recepsaglam/umay/hardware/umay/docs/PCBTopView.png

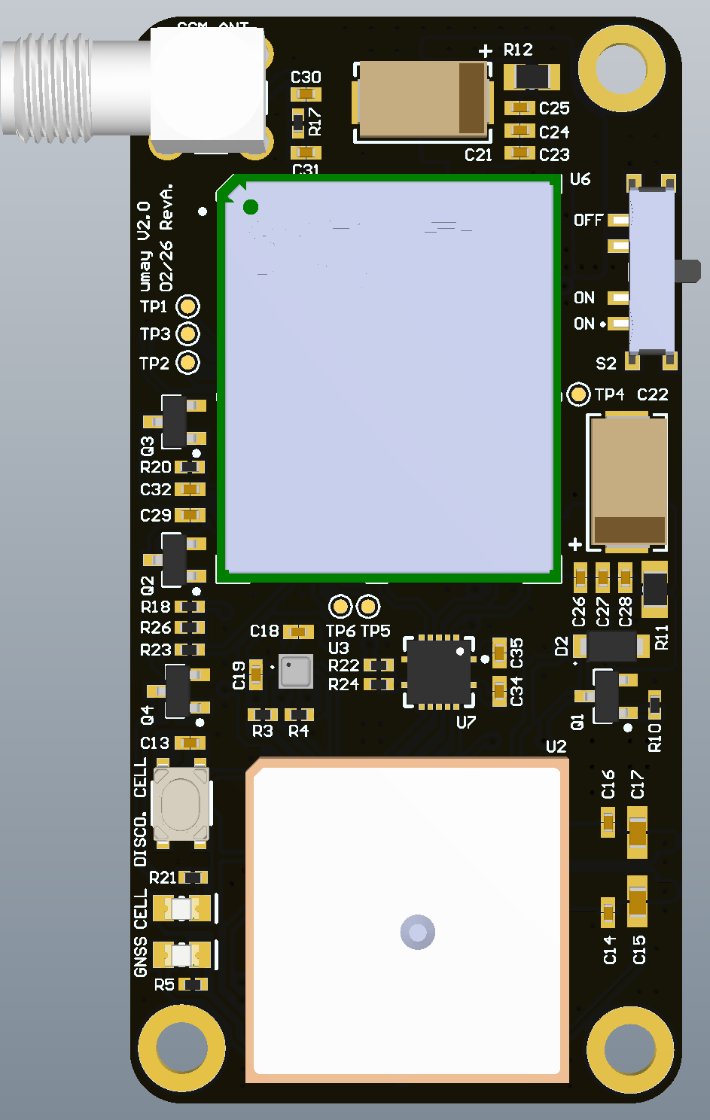
hardware/umay/docs/PCBTopView.png
