recepsaglam/umay/docs/GNSS_and_GSM_Module_Selection.docx

Module Selection Justification

Within the scope of the UMAY project, the Quectel EG915N has been selected as the primary communication module. This decision was made after a detailed evaluation of technical, logistical, and operational factors.

1. Availability and Supply Chain Reliability

The EG915N module is widely available in the Turkish market, offered by multiple authorized distributors. This ensures short lead times and reduces the risks associated with supply disruptions.
In contrast, the SIMCom A7672E module is available through a limited number of vendors, introducing potential sourcing and continuity risks during production.

2. Cost and Integration Advantages

The EG915N provides a cost-effective and integration-friendly solution among LTE Cat 1 modules. Its design requires fewer external components, which simplifies PCB layout and lowers overall system cost.
Additionally, the module’s low power consumption makes it well-suited for battery-powered applications, aligning with the UMAY project’s objective of maximizing endurance and operational efficiency.

3. Technical Capability and Future-Proof Architecture

Supporting LTE Cat 1 connectivity with 2G fallback, the EG915N ensures reliable data transmission even in regions with limited LTE coverage.
Modules based solely on 2G technology were excluded, as 2G networks are gradually being phased out in many regions and cannot meet the project’s performance and latency requirements.
Therefore, adopting an LTE Cat 1 module ensures long-term compatibility, improved throughput, and reduced latency, making the system more robust and sustainable.

4. Manufacturing Considerations

The EG915N utilizes an LCC/LGA package, which may present soldering challenges during manufacturing. However, with appropriate PCB footprint design and optimized reflow soldering parameters, reliable assembly quality can be achieved.

5. GNSS Performance Optimization

Although the EG915N includes a built-in GNSS receiver, its performance heavily depends on antenna characteristics.
In particular, chip antennas typically operate near the minimum Carrier-to-Noise Density (C/N₀) threshold required for stable navigation message decoding.
This means that, to achieve reliable GNSS performance using the EG915N’s internal receiver, a ceramic patch antenna would be required.
However, integrating such an antenna would eliminate the size advantage of the chip antenna approach and add design complexity.

For this reason, the decision was made to include a dedicated u-blox L86 GNSS module.
While the L86 introduces additional cost and higher power consumption, it provides significantly improved positioning reliability, multi-constellation support (GPS, GLONASS, GALILEO), and faster Time to First Fix (TTFF) performance.
This ensures accurate and consistent position tracking even under challenging signal conditions.

Summary

The selection of the Quectel EG915N was primarily driven by:

- Cost efficiency and strong local market availability,
- Simplified integration and low power operation,
- LTE Cat 1 capability with reliable 2G fallback,
- Long-term network sustainability.

Furthermore, the integration of the L86 GNSS module—instead of relying on the EG915N’s internal GNSS—was based on performance considerations.
Although it increases cost and power consumption, it provides a more stable and precise positioning subsystem, ensuring that the UMAY project achieves high reliability in real-world operational conditions.
