recepsaglam/umay/hardware/umay/docs/PCBBottomView.png

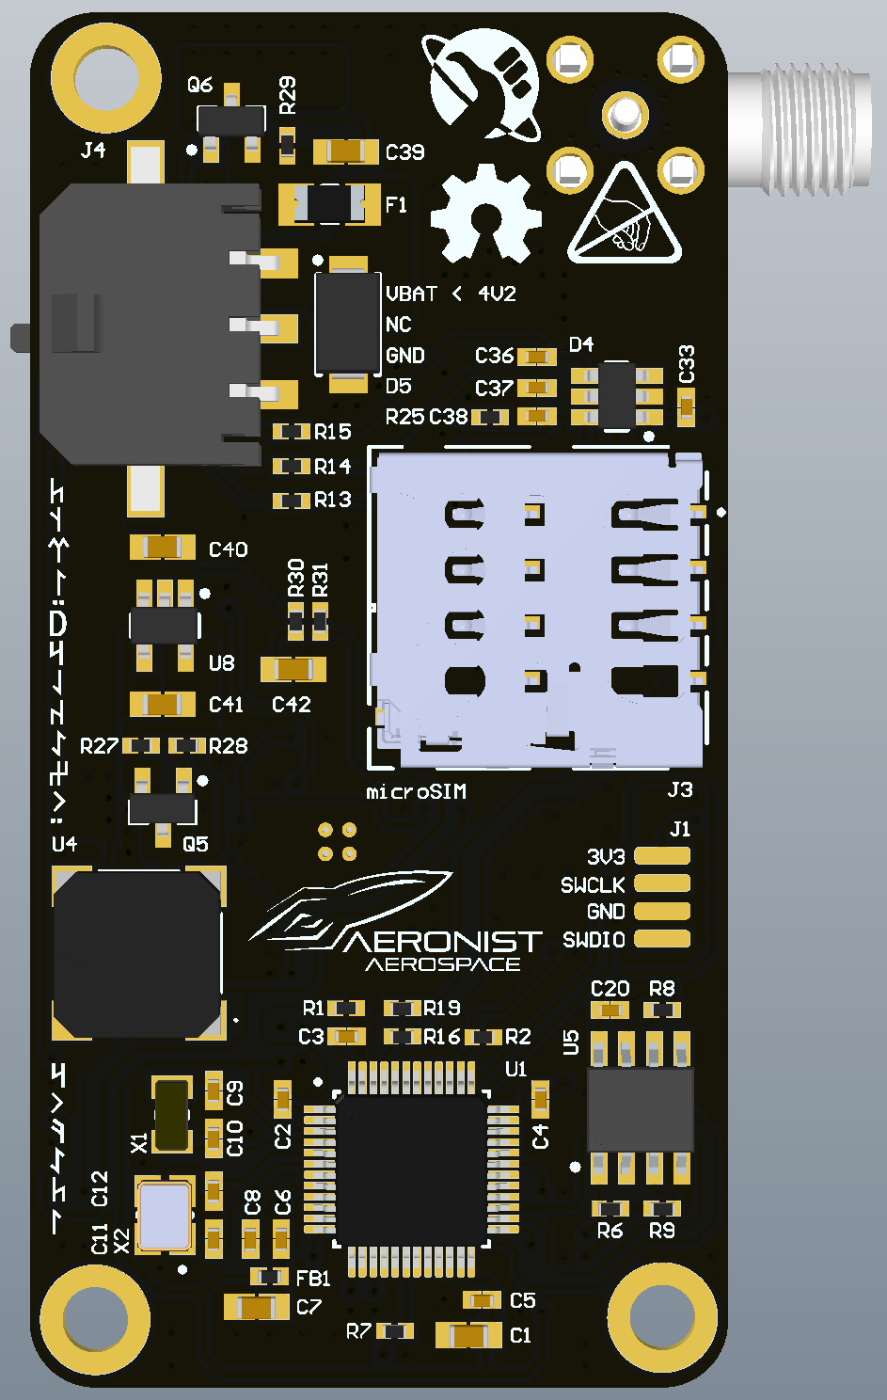
hardware/umay/docs/PCBBottomView.png
