recepsaglam/umay/hardware/umay/fabrication/umayBOM.xlsx

 | Bill of Materials
 | Source Data From: | umay.PrjPcb
 | Project File Name: | umay.PrjPcb
 | Report Date: | 4.03.2026
 | Author:
Designator | Comment | Footprint | Description | Quantity | Supplier Part Number 1 | Supplier 1 | Supplier Unit Price 1 | Link
C1, C17 | 4u7 | CAP 0603 | Capacitor SMD 0603 | 2
C2, C3, C4, C5, C6, C8, C13, C14, C16, C18, C19, C20, C25, C28, C33, C34, C35 | 100n | CAP 0402 | Capacitor SMD 0402 | 17
C7, C39, C40, C41, C42 | 1u | CAP 0603 | Capacitor SMD 0603 | 5
C9, C10 | 6p | CAP 0402 | Capacitor SMD 0402 | 2
C11, C12 | 18p | CAP 0402 | Capacitor SMD 0402 | 2
C15 | 10u | CAP 0603 | Capacitor SMD 0603 | 1
C21, C22 | 100u | CAP TANT D Case | Capacitor Tantalum SMD D Case | 2
C23, C26 | 10p | CAP 0402 | Capacitor SMD 0402 | 2
C24, C27, C36, C37, C38 | 33p | CAP 0402 | Capacitor SMD 0402 | 5
C29, C32 | 10n | CAP 0402 | Capacitor SMD 0402 | 2
C30, C31 | NM | CAP 0402 | Capacitor SMD 0402 | 2
D1, D3 | LED 0805 | LED 0805 | LED 0805 SMD | 2
D2 | SS2060FL | SOD-123FL | Rectifier Diode, Schottky, 1 Phase, 1 Element, 2A, 60V V(RRM), Silicon | 1
D4 | SRV05-4 | SOT-23-6 | SRV Series 17.5 V 3 pF SMT RailClamp® Low Capacitance TVS Diode Array SOT-23-6 | 1
D5 | SMAJ5.0A-E3/61 | SMA | SMAJ Series SMT Bi/Uni-Directional Transient Voltage Suppressor - SMA | 1
F1 | KLM3S350RY | PTC 1206 | PTC Resettable Fuse | 1
FB1 | 600 Ω @ 100 MHz | FB 0402 | Ferrite Bead SMD 0402 | 1
J1 | CONN 1x4 Pad 1.27mm | CONN 1x4 PAD 1.27mm | 1×4 pin header connector, 1.27 mm pitch. | 1
J2 | L-KLS1-SMA-KWE-7X7-15.1 | CONN SMA THT R/A | RF SMA Connector, 1 Contact(s), Board Mount, R/A | 1
J3 | 115I-AEAA | 115I-AEAA | 115I-AEAA Connector Micro SIM Card Push-Pull 6P SMD Card Edge Connectors | 1
J4 | L-KLS1-XM1-3.00-1X03-RT | CONN 1X3 MICRO-FIT 3.00MM | 1×2 Micro Fit type connector, 3.0 mm pitch, surface-mount. | 1
Q1, Q2, Q3, Q4 | PJA3404A | SOT23-3 | SOT-23-3 package, N-Channel MOSFET | 4
Q5, Q6 | SI2365EDS | SOT23-3 | SOT-23-3 package, P-Channel MOSFET | 2
R1, R2, R22 | 10k | RES 0402 | Resistor SMD 0402 | 3
R3, R4, R6, R7, R8, R9, R16, R19, R23 | 4k7 | RES 0402 | Resistor SMD 0402 | 9
R5, R21 | 1k | RES 0402 | Resistor SMD 0402 | 2
R10, R18, R20, R26 | 47k | RES 0402 | Resistor SMD 0402 | 4
R11, R12 | 0R | RES 0805 | Resistor SMD 0805 | 2
R13, R14, R15, R17 | 0R | RES 0402 | Resistor SMD 0402 | 4
R24 | 120k | RES 0402 | Resistor SMD 0402 | 1
R25 | 15k | RES 0402 | Resistor SMD 0402 | 1
R27, R31 | 100k | RES 0402 | Resistor SMD 0402 | 2
R28 | 330R | RES 0402 | Resistor SMD 0402 | 1
R29, R30 | 33k | RES 0402 | Resistor SMD 0402 | 2
S1 | SW Tact 4.6x3.2mm | SW TACT 4.6X3.2MM | 4.6×3.2 mm tactile push-button switch, SPST, momentary, SMD. | 1
S2 | SSSS812201 | SSSS812201 | Slide Switch / Switch Slide SP3T Side Slide 0.3A 5VDC 10000Cycles Gull Wing SMD T/R | 1
TP1, TP2, TP3, TP4, TP5, TP6 | Test Point | Test Point | Test Point, PCB Pad Only, Ø1.2mm | 6
U1 | STM32L071CBT6 | LQFP48 | MCU 32-Bit Ultra Low Power STM32L ARM Cortex M0+ RISC 128kB Flash 48-Pin LQFP Tray | 1
U2 | L86-M33 | L86-M33 | GNSS Module, Galileo, GLONASS, GPS, QZSS, 1.57542GHz, 1.60171GHz, -167 dBm, 35 s, 3V to 4.3V | 1
U3 | BMP390 | BMP390 | Pressure sensor, 300-1250hPa, 2.0*2.0*0.75mm, I2C/SPI | 1
U4 | MTS7525A04LM | MTS7525A04LM | 7.5 x 7.5 mm magnetic passive buzzer, SMT, 3.6 V (2.5–4.5 V), 2.7 kHz, 85 dB. | 1
U5 | W25Q64JVSSIQ | SOP-8 | NOR Flash Serial (SPI, Dual SPI, Quad SPI) 3V/3.3V 64M-bit 8M x 8 6ns 8-Pin SOIC T/R/Tray/Tube | 1
U6 | EG915N-EA | EG915N | Cellular, Navigation BeiDou, EDGE, Galileo, GLONASS, GNSS, GPRS, GPS, GSM, HSPA+, LTE, UMTS, WCDMA Transceiver Module 915MHz Antenna Not Included Surface Mount | 1
U7 | TXS0104ERGYR | VQFN-14 | Four-bit bidirectional voltage-level shifter for open-drain and push-pull applications 14-VQFN -40 to 85 | 1
U8 | TLV73333PDBVR | SOT23-5 | 300-mA, capacitor-free, low-IQ, low-dropout voltage regulator with enable 5-SOT-23 -40 to 125 | 1
X1 | RT3215-32.768-6 | RT3215-32.768-X | Parallel - Fundamental Quartz Crystal, 0.032768MHz Nom | 1
X2 | RH100-8.000-12.5 | RH100 | RH100 Series Crystal, X Mhz, X pF, Smd, 3.2Mm X 2.5Mm Raltron | 1
 |  |  |  | 106 |  |  | ₺0.00
