recepsaglam/umay/(list of files, cad)

Other CAD files:
mechanical/LiPo_1S.CATPart
mechanical/SMA_Antenna.CATPart
mechanical/case.CATProduct
mechanical/case_bottom.CATPart
mechanical/case_top.CATPart
mechanical/umay.CATPart
