recepsaglam/umay/hardware/umay/docs/umaySCH.pdf

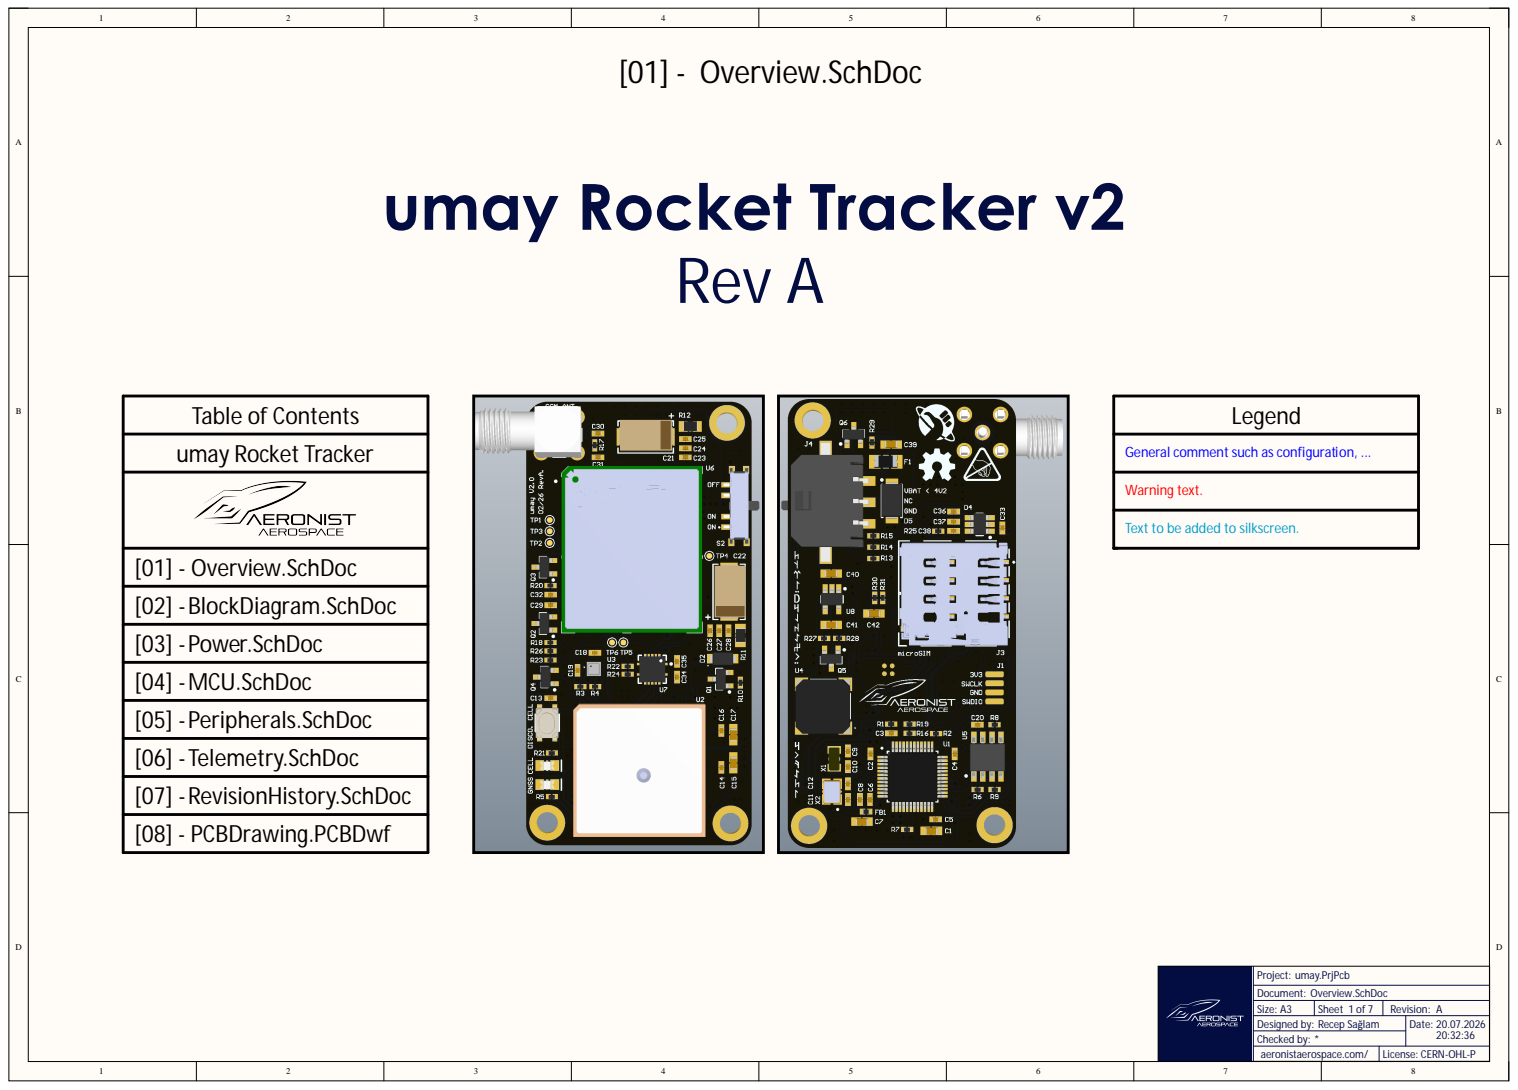
[picture p3: page 1]

General comment such as configuration, ...

Text to be added to silkscreen.

Size: A3 | Sheet of 1 7 | Revision: A
Designed by: Recep Sağlam | Date: 20.07.2026 20:32:36

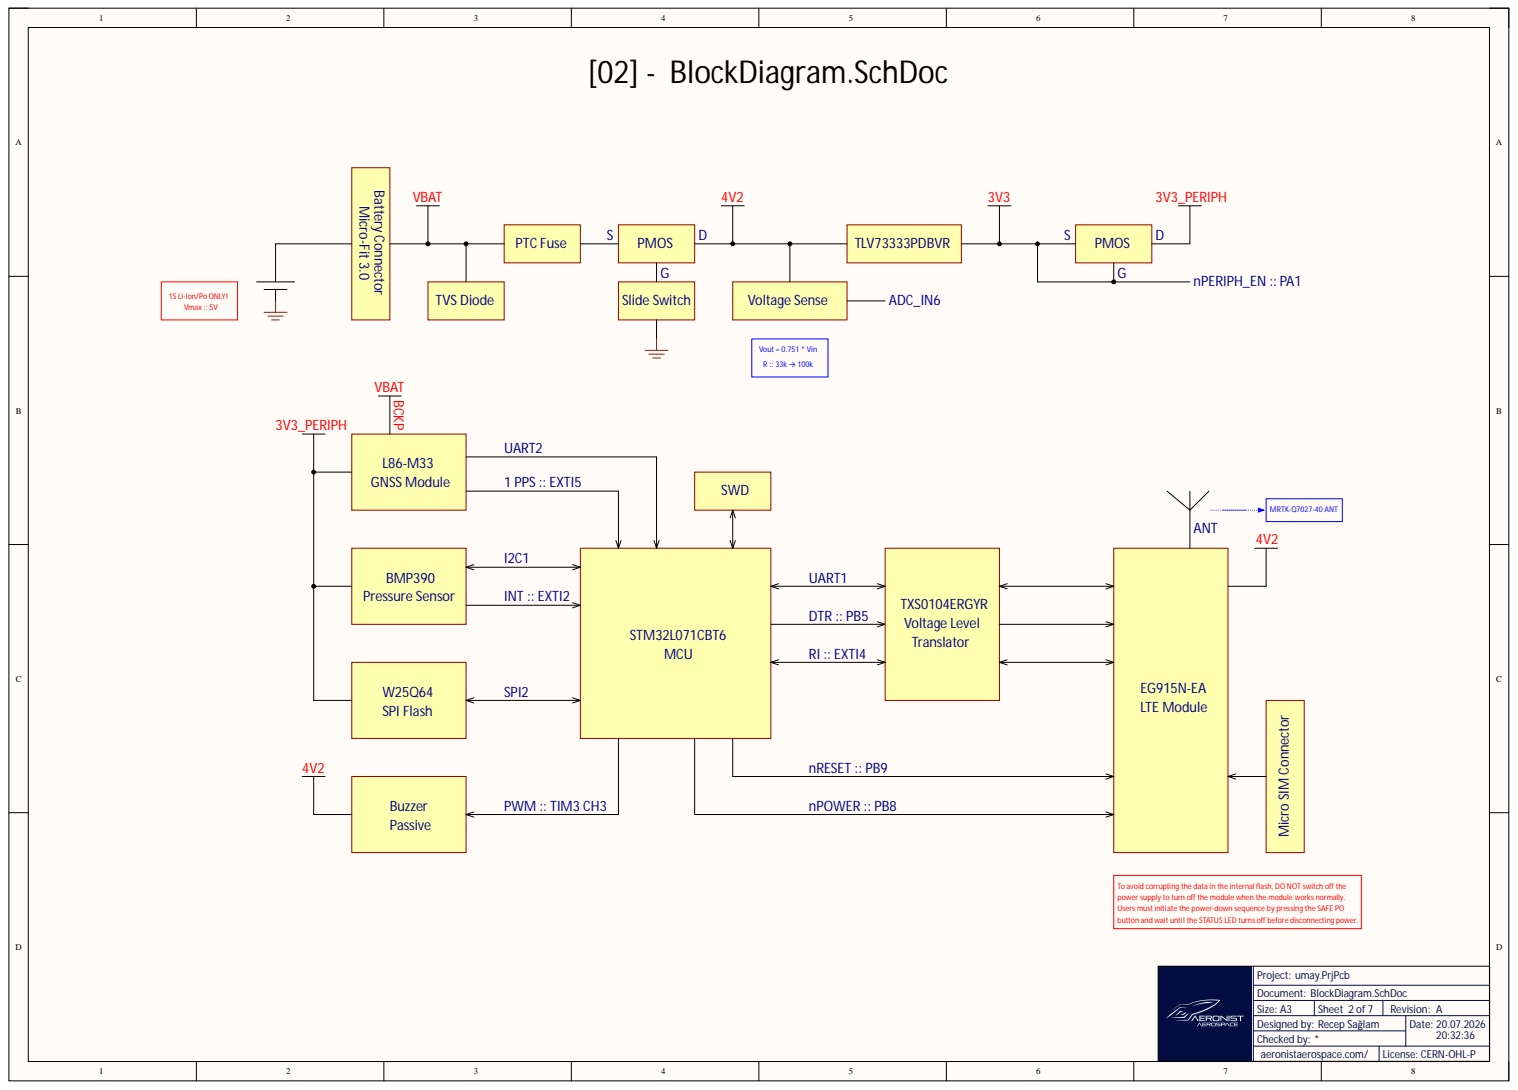
[picture p4: page 2]

1S Li-Ion/Po ONLY!
Vmax :: 5V

To avoid corrupting the data in the internal flash, DO NOT switch off the
power supply to turn off the module when the module works normally.
Users must initiate the power-down sequence by pressing the SAFE PO
button and wait until the STATUS LED turns off before disconnecting power.

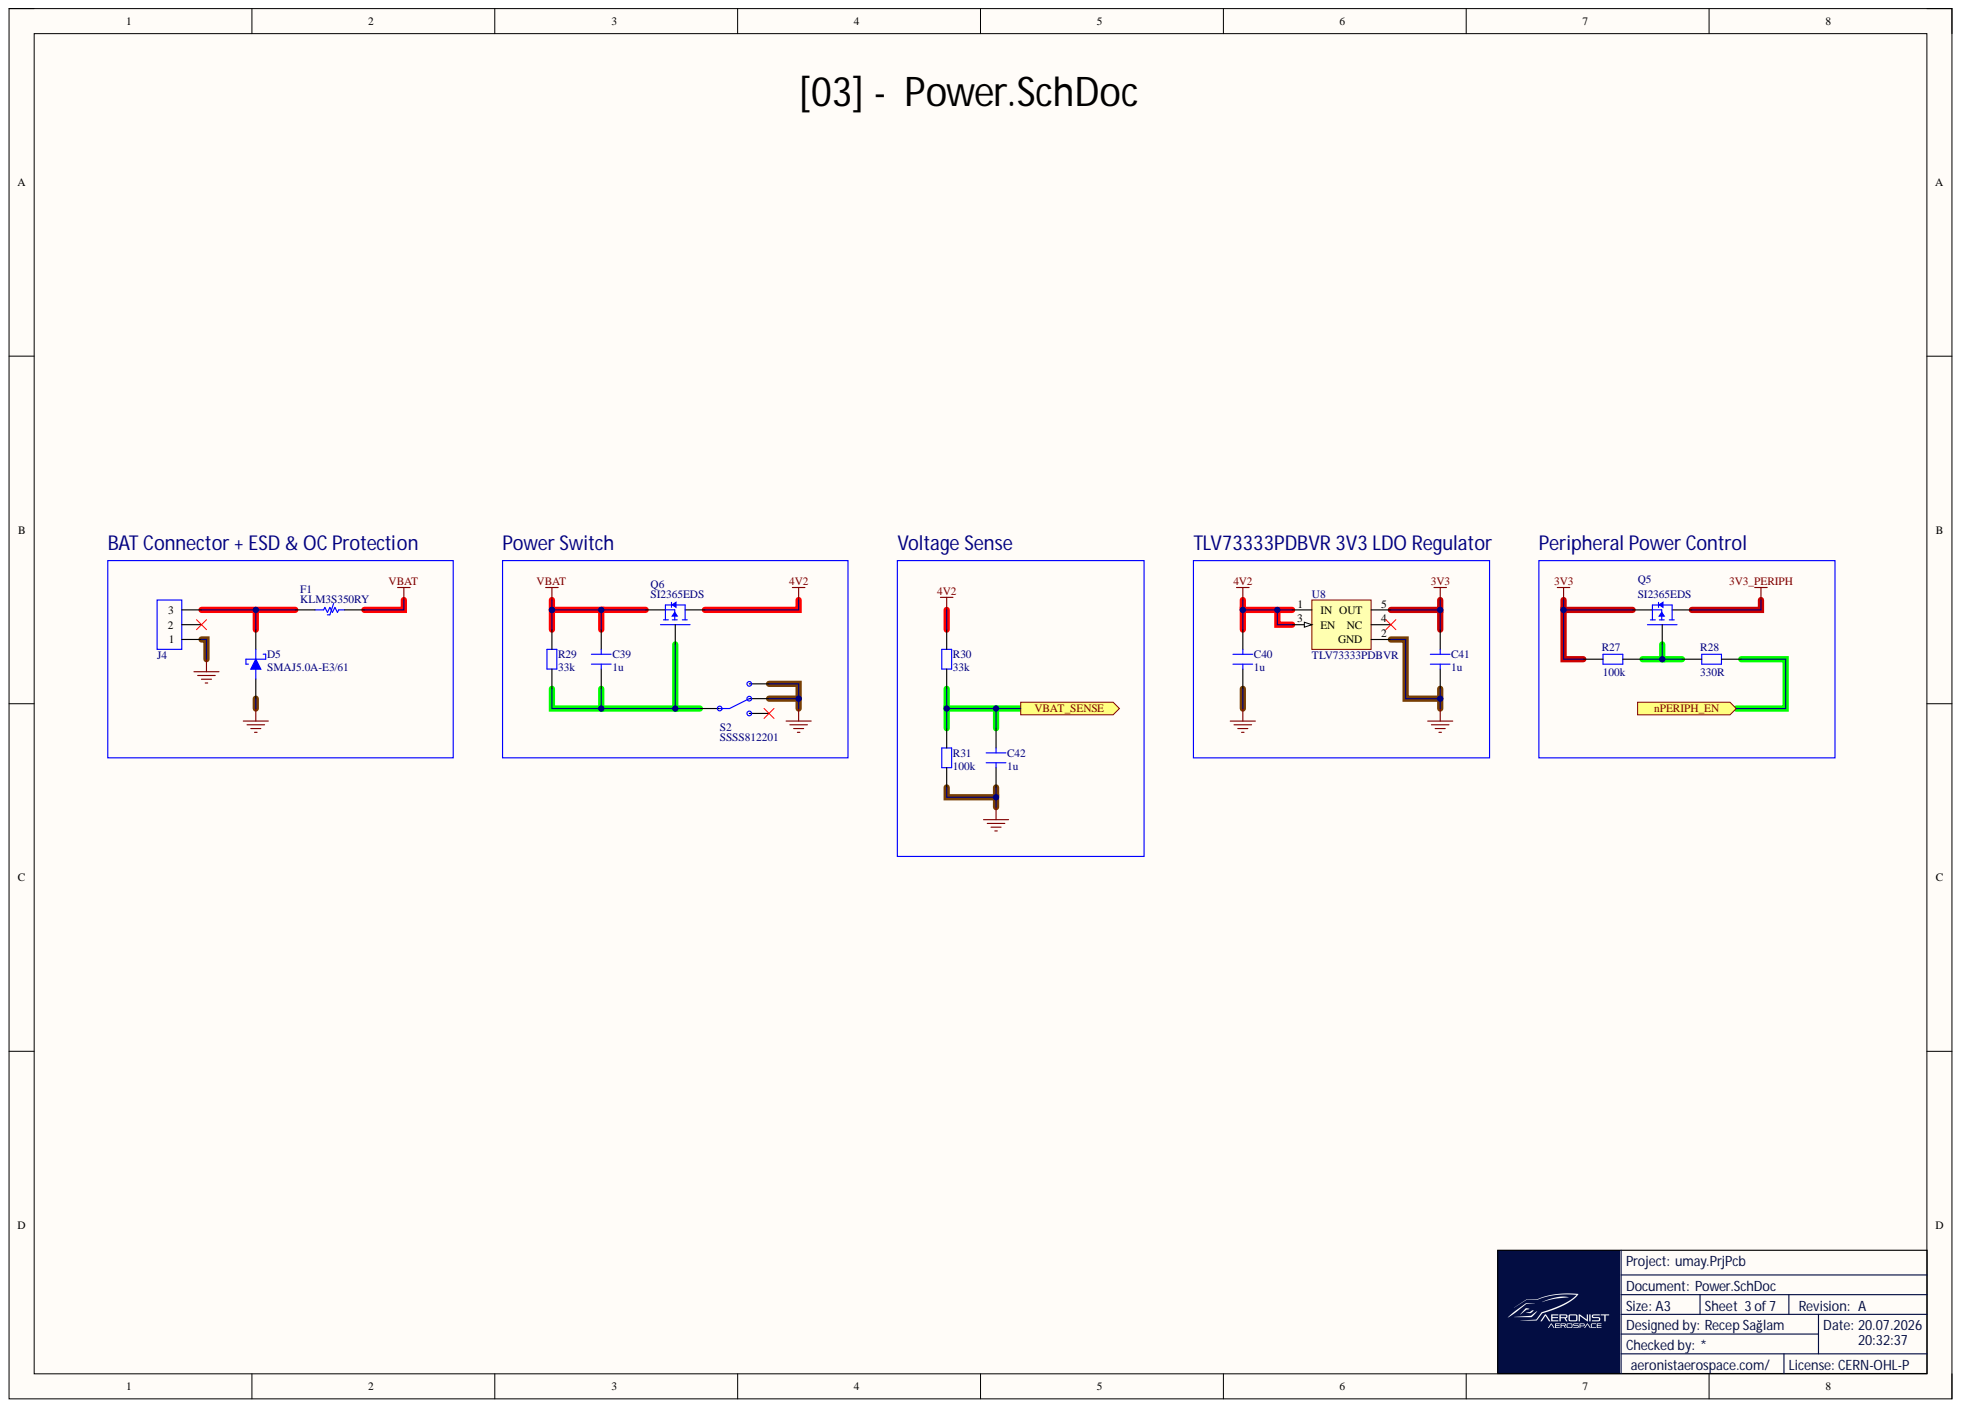
[picture p5: page 3]

BAT Connector + ESD & OC Protect

umay.PrjPcb Power.SchDoc

Size: A3 | | Revision: A

Sheet of Recep Sağlam | 20.07.2026 *

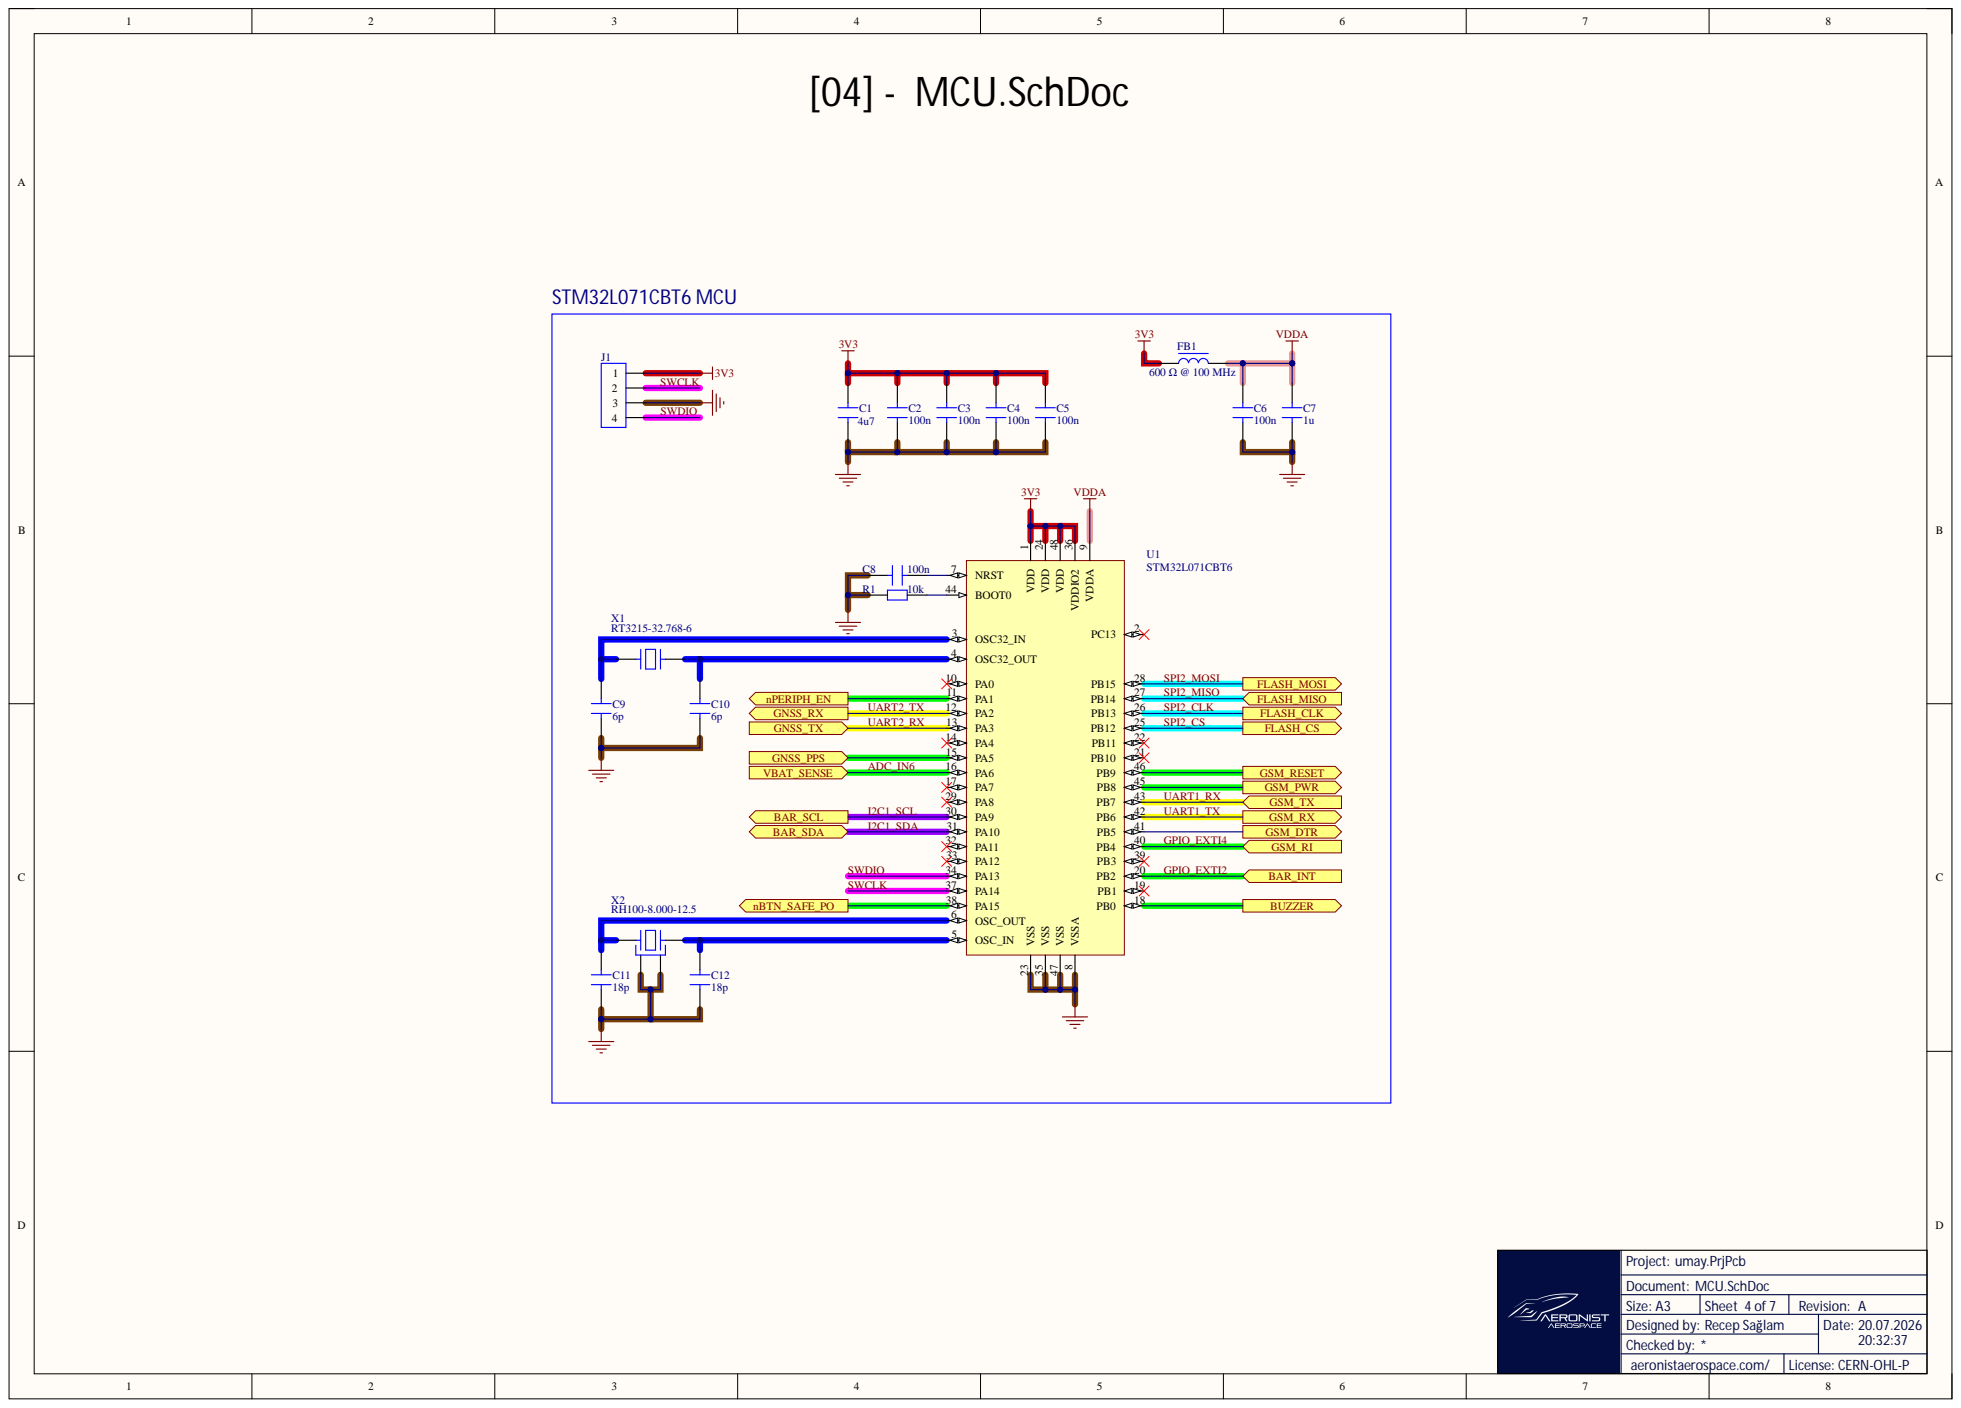
[picture p6: page 4]

OSC32_OUT 4

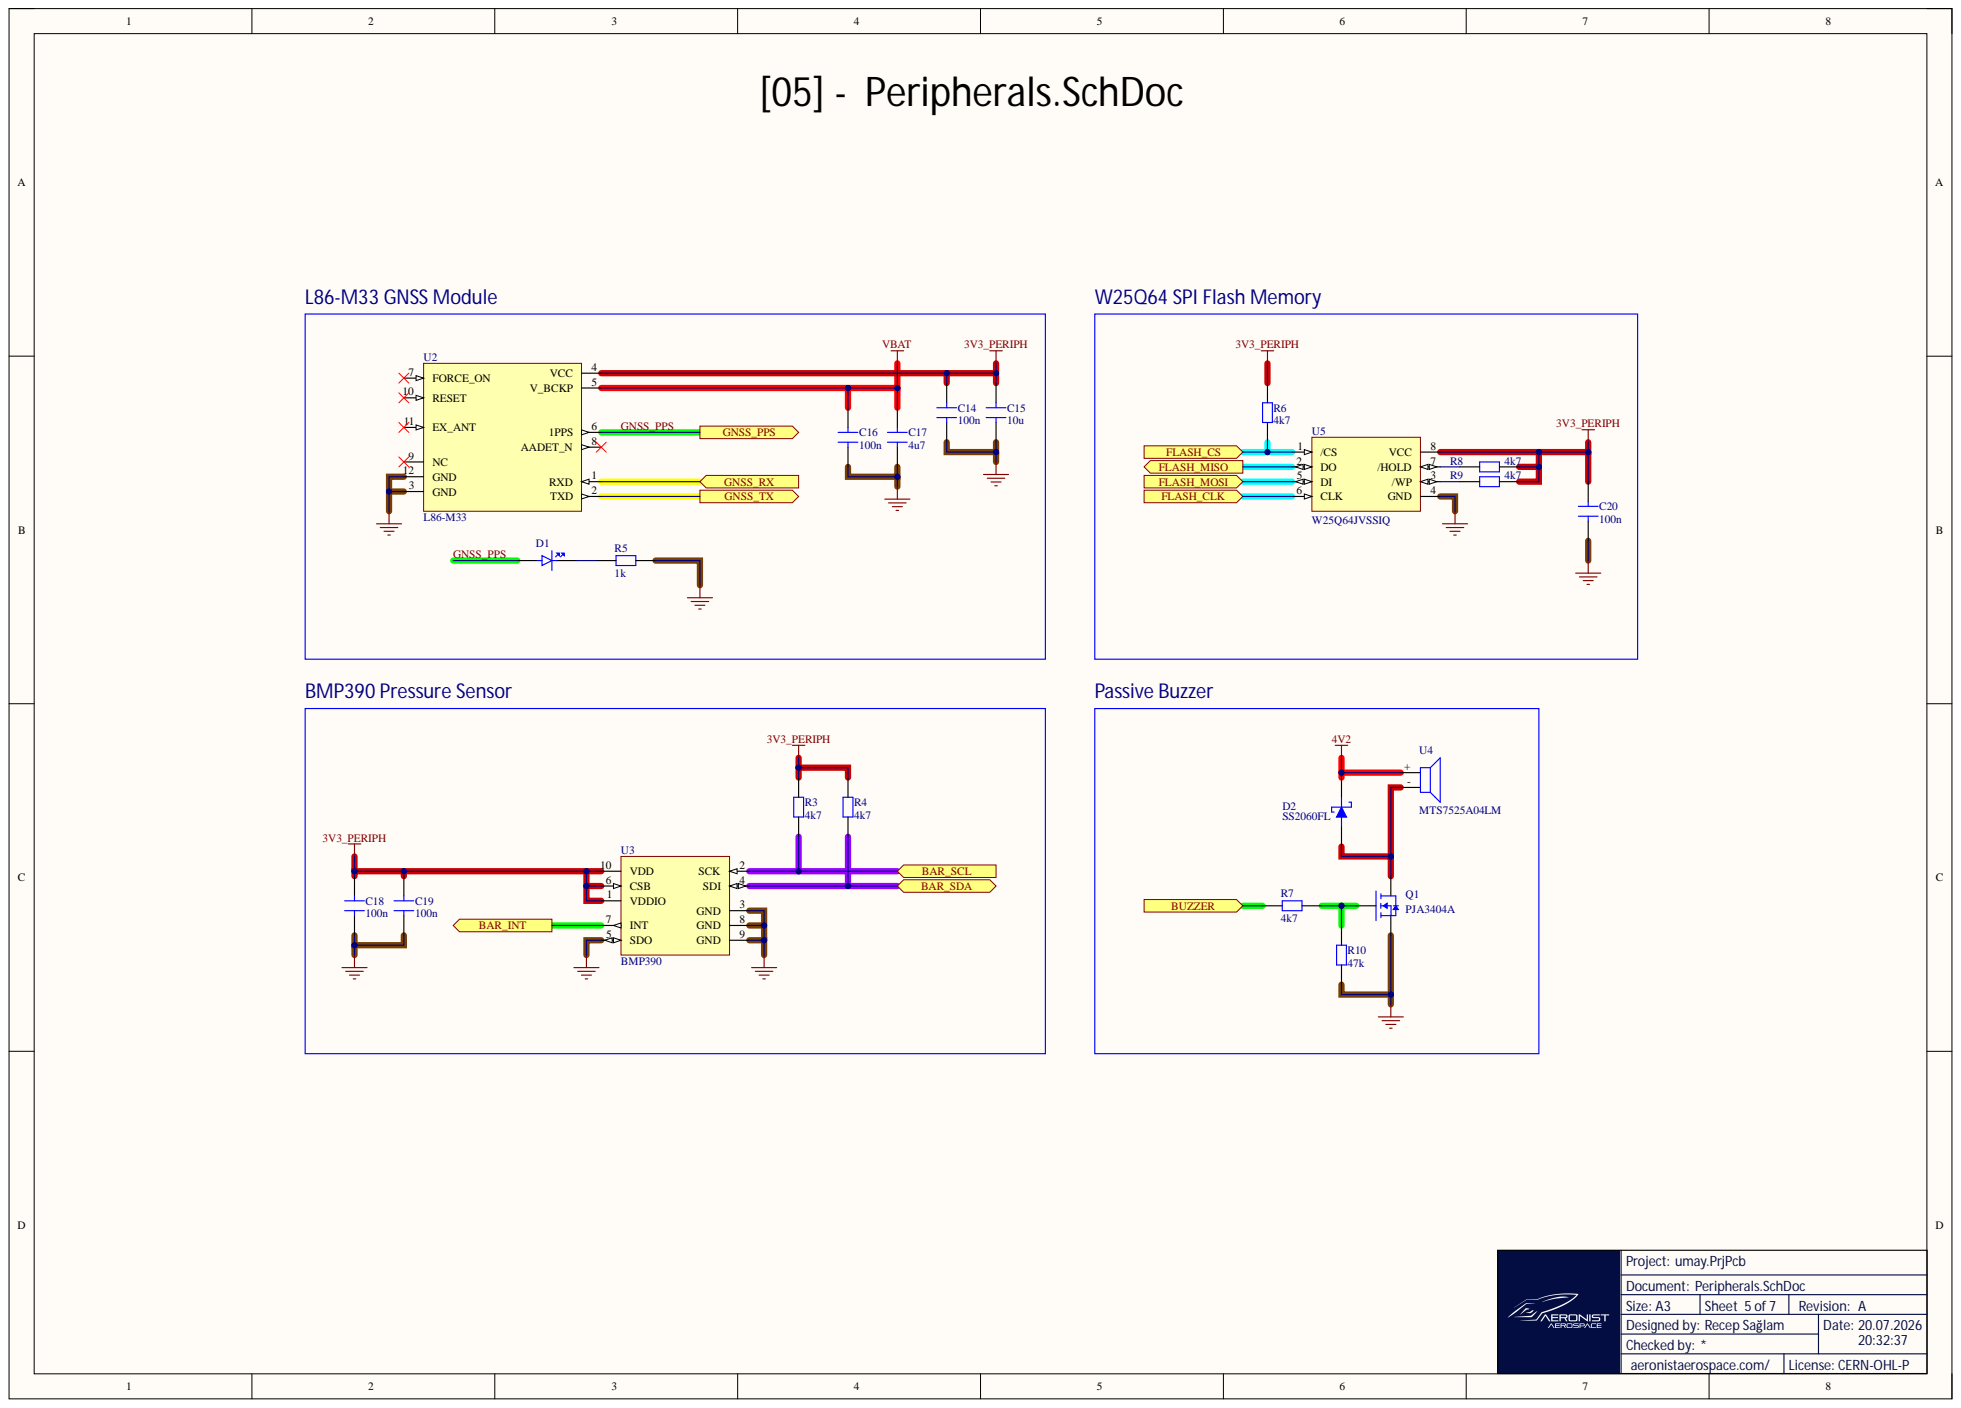
[picture p7: page 5]

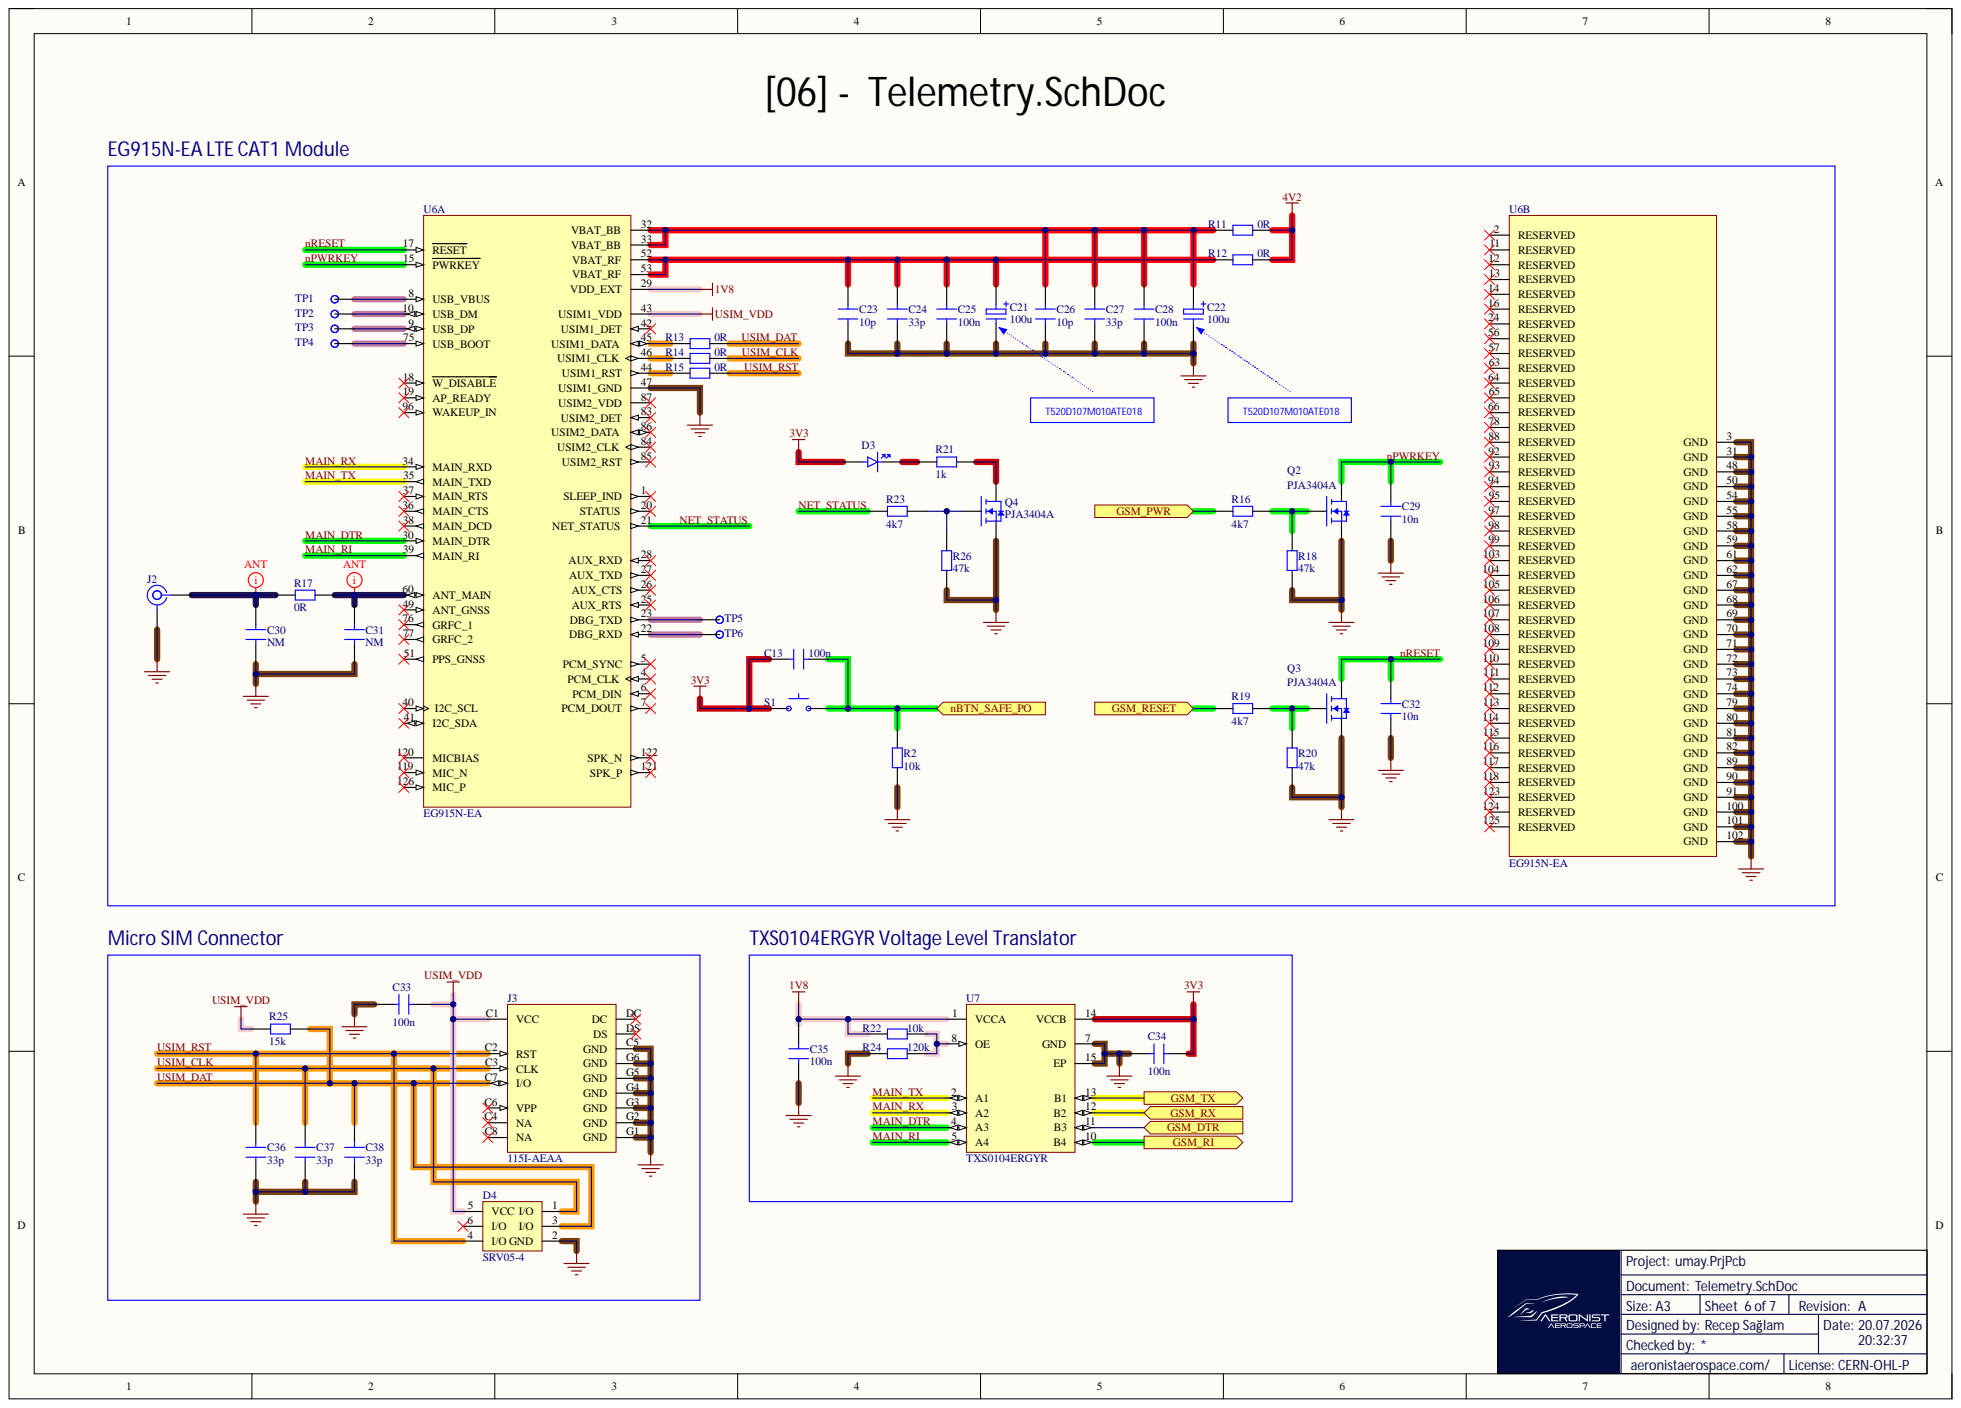
[picture p8: page 6]

Project: umay.PrjPcb

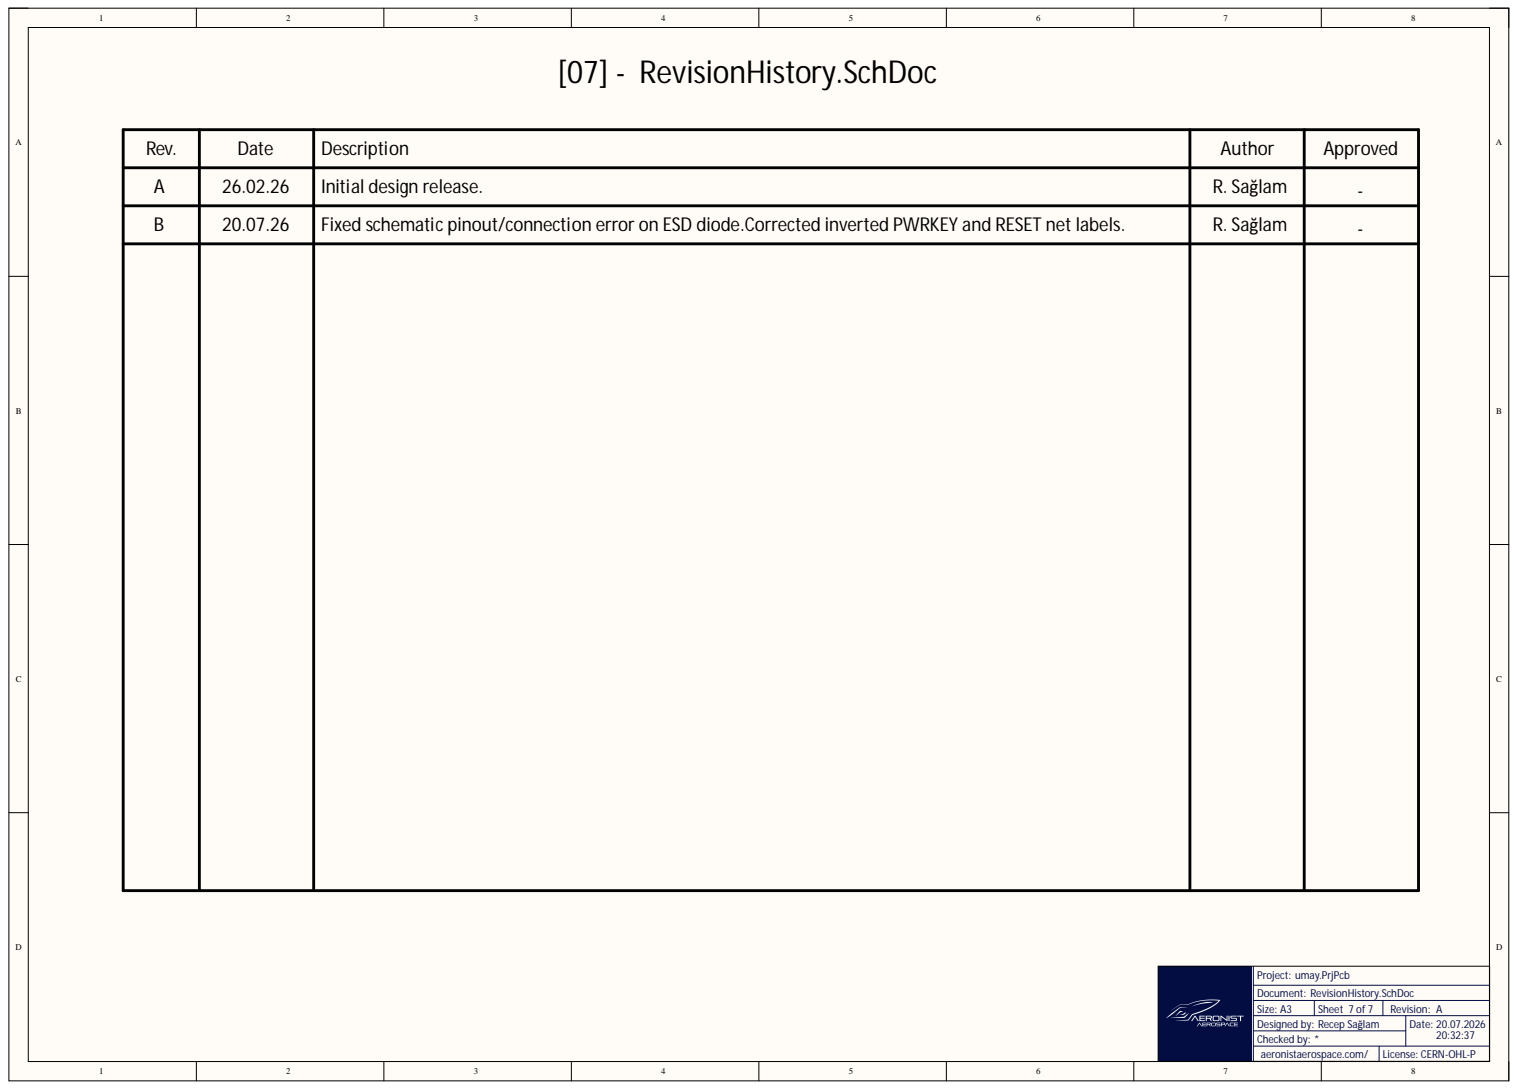
[picture p9: page 7]

Rev. | Date | Description | Author | Approved

A | 26.02.26 | | R. Sağlam | - Initial design release.

B | 20.07.26 | Fixed | R. Sağlam | - schematic pinout/connection error on ESD diode.Corrected inverted PWRKEY and RESET net labels.
