recepsaglam/umay/(list of files, drawings)

Other design files:
hardware/umay/design/BlockDiagram.SchDoc
hardware/umay/design/MCU.SchDoc
hardware/umay/design/Overview.SchDoc
hardware/umay/design/Peripherals.SchDoc
hardware/umay/design/Power.SchDoc
hardware/umay/design/RevisionHistory.SchDoc
hardware/umay/design/Telemetry.SchDoc
hardware/umay/design/umay.PcbDoc
hardware/umay/umay.PrjPcb
