recepsaglam/umay/hardware/umay/design/Out/sizes.ini

[Page0.emf]
Pixel_PrintingWidth=9300
Pixel_PrintingHeight=6660
Mils_PrintingHeight=11100
Mils_PrintingWidth=15500
[Page1.emf]
Pixel_PrintingWidth=9300
Pixel_PrintingHeight=6660
Mils_PrintingHeight=11100
Mils_PrintingWidth=15500
[Page2.emf]
Pixel_PrintingWidth=9300
Pixel_PrintingHeight=6660
Mils_PrintingHeight=11100
Mils_PrintingWidth=15500
[Page3.emf]
Pixel_PrintingWidth=9300
Pixel_PrintingHeight=6660
Mils_PrintingHeight=11100
Mils_PrintingWidth=15500
[Page4.emf]
Pixel_PrintingWidth=9300
Pixel_PrintingHeight=6660
Mils_PrintingHeight=11100
Mils_PrintingWidth=15500
[Page5.emf]
Pixel_PrintingWidth=9300
Pixel_PrintingHeight=6660
Mils_PrintingHeight=11100
Mils_PrintingWidth=15500
[Page6.emf]
Pixel_PrintingWidth=9300
Pixel_PrintingHeight=6660
Mils_PrintingHeight=11100
Mils_PrintingWidth=15500
